Modurail/NGM-Power-Box/README.md

# NGM Power Box
- Operational and wiring schematic for the NGM layout control box (2016 version).
- The project and the associated schematics and libraries are built using [KiCad EDA](http://kicad-pcb.org//).
- The project is managed on a [Trello project board](https://trello.com/b/fsGp1QEj).
