Modurail/NGM-Power-Box/KiCad Schematics/2016 1115 Power Box Schematic.pdf

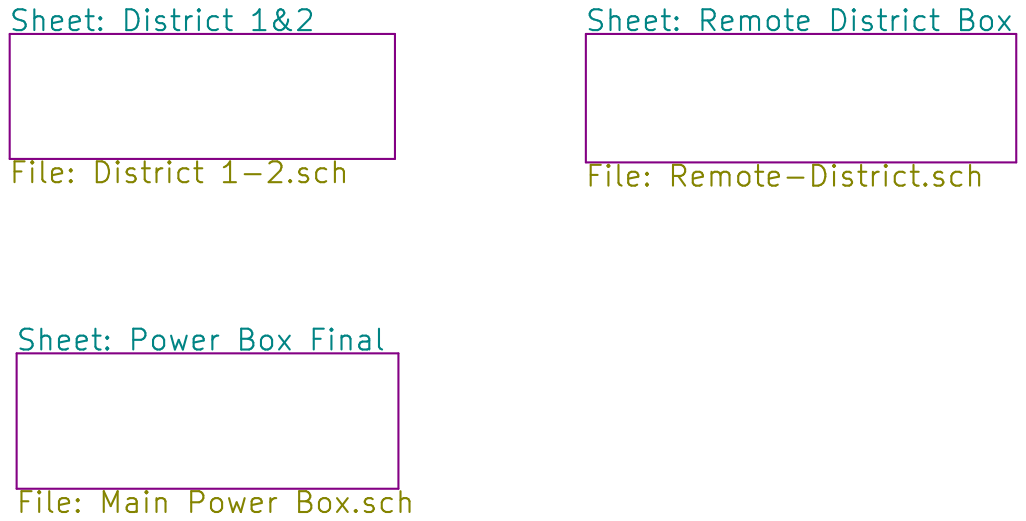
[picture p1: page 1]

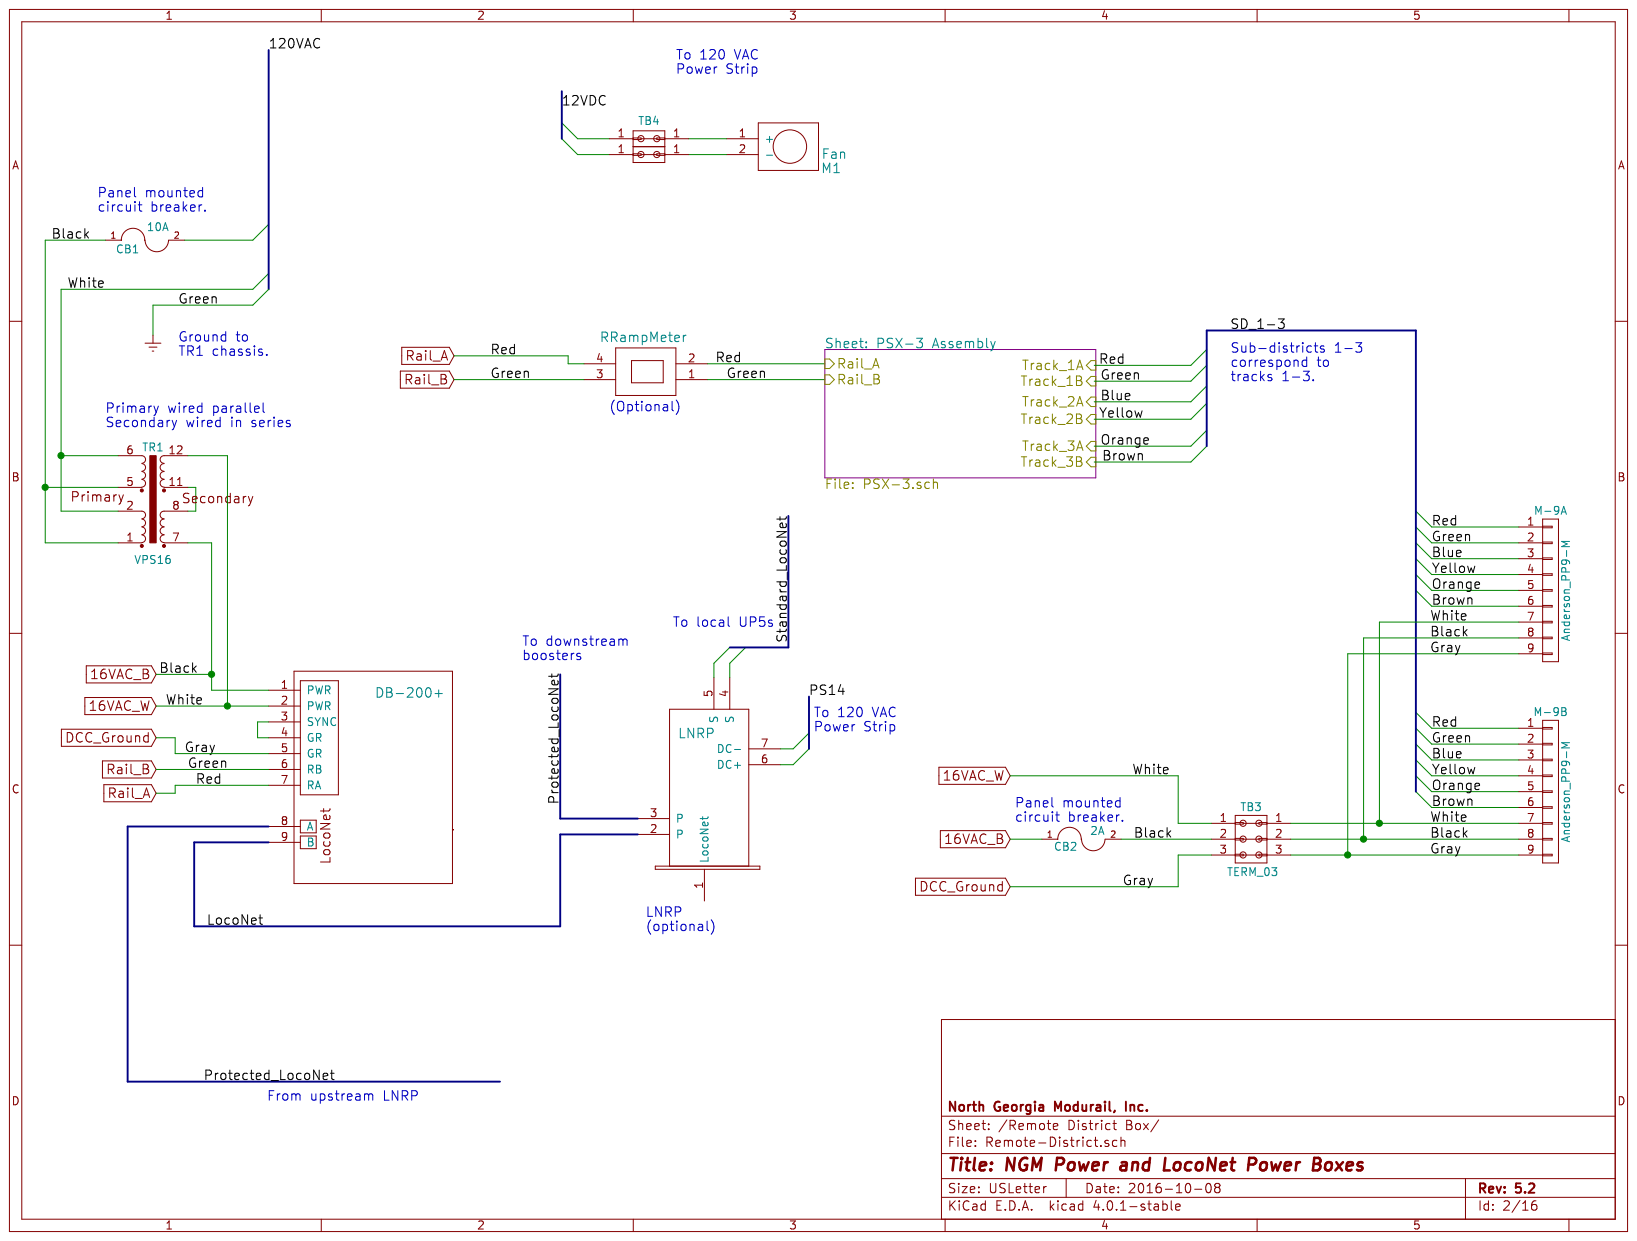
[picture p2: page 2]

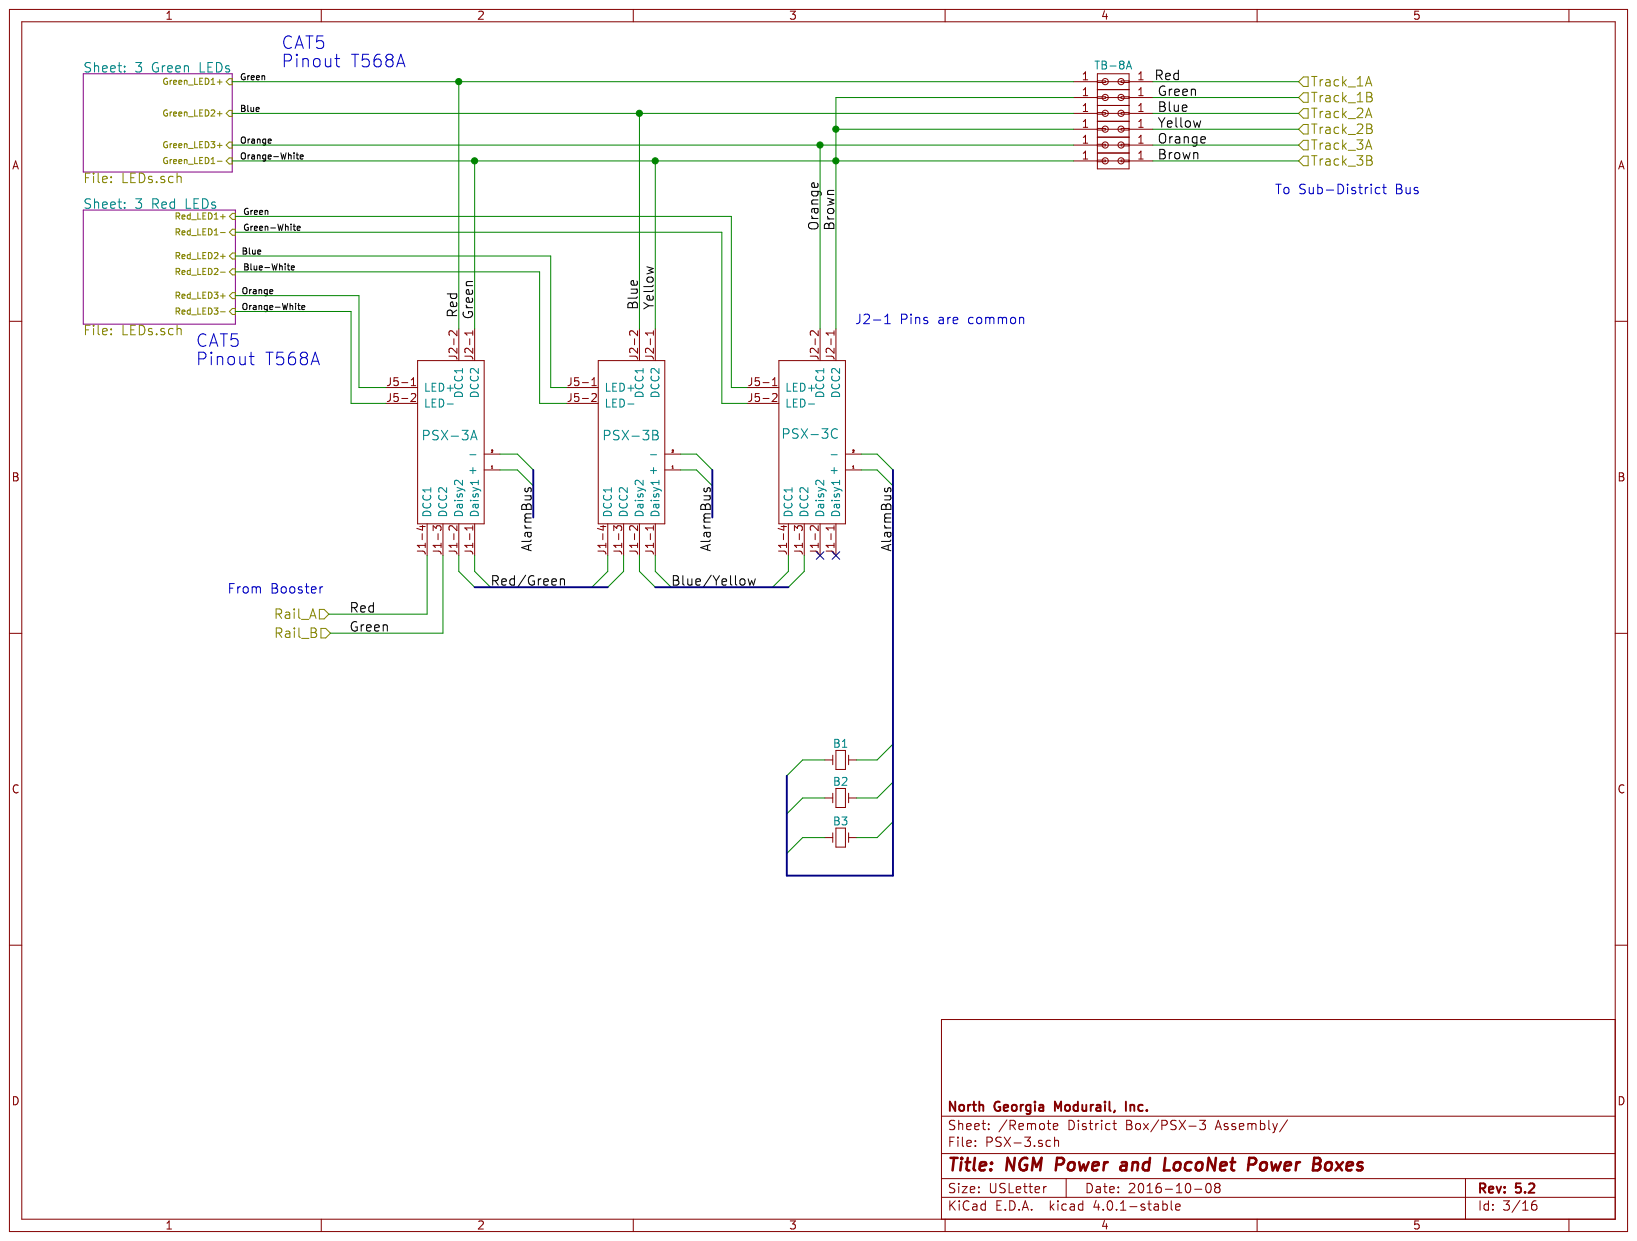
[picture p3: page 3]

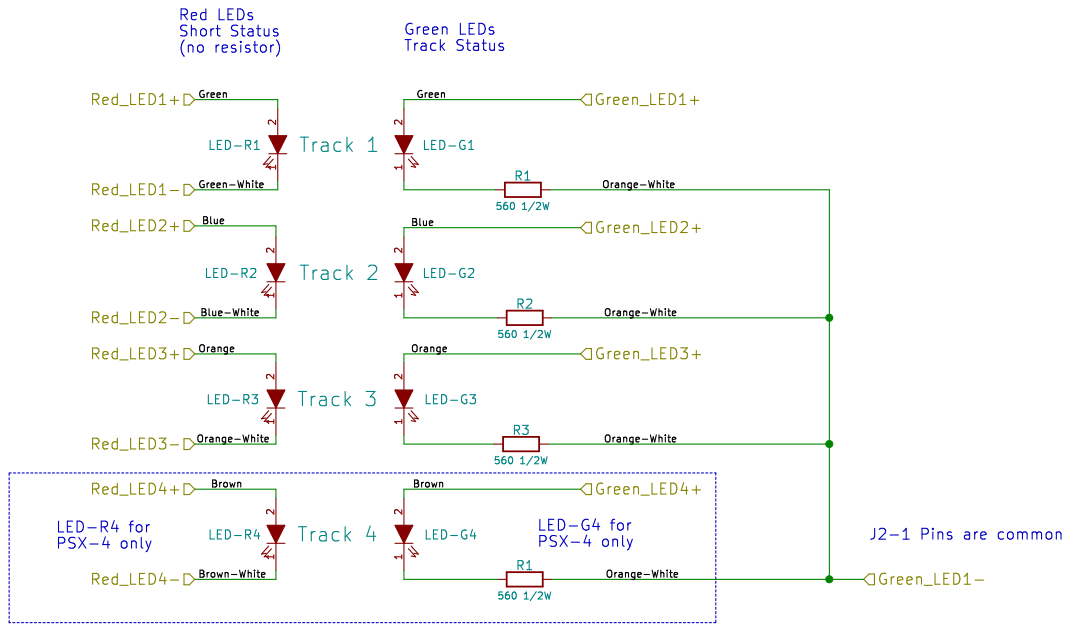
[picture p4: page 4]

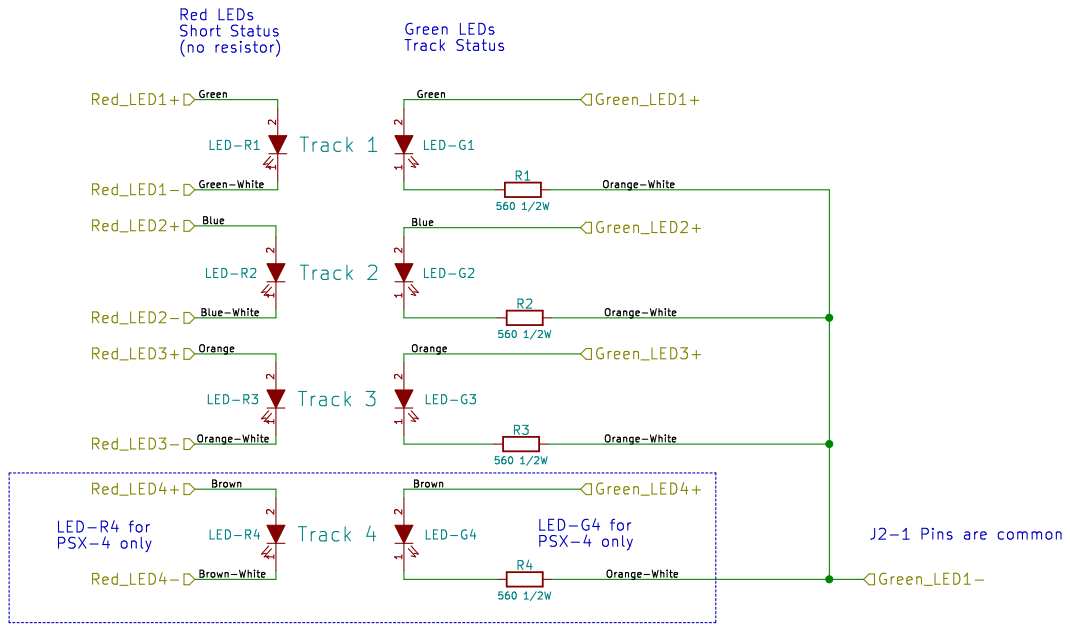
[picture p5: page 5]

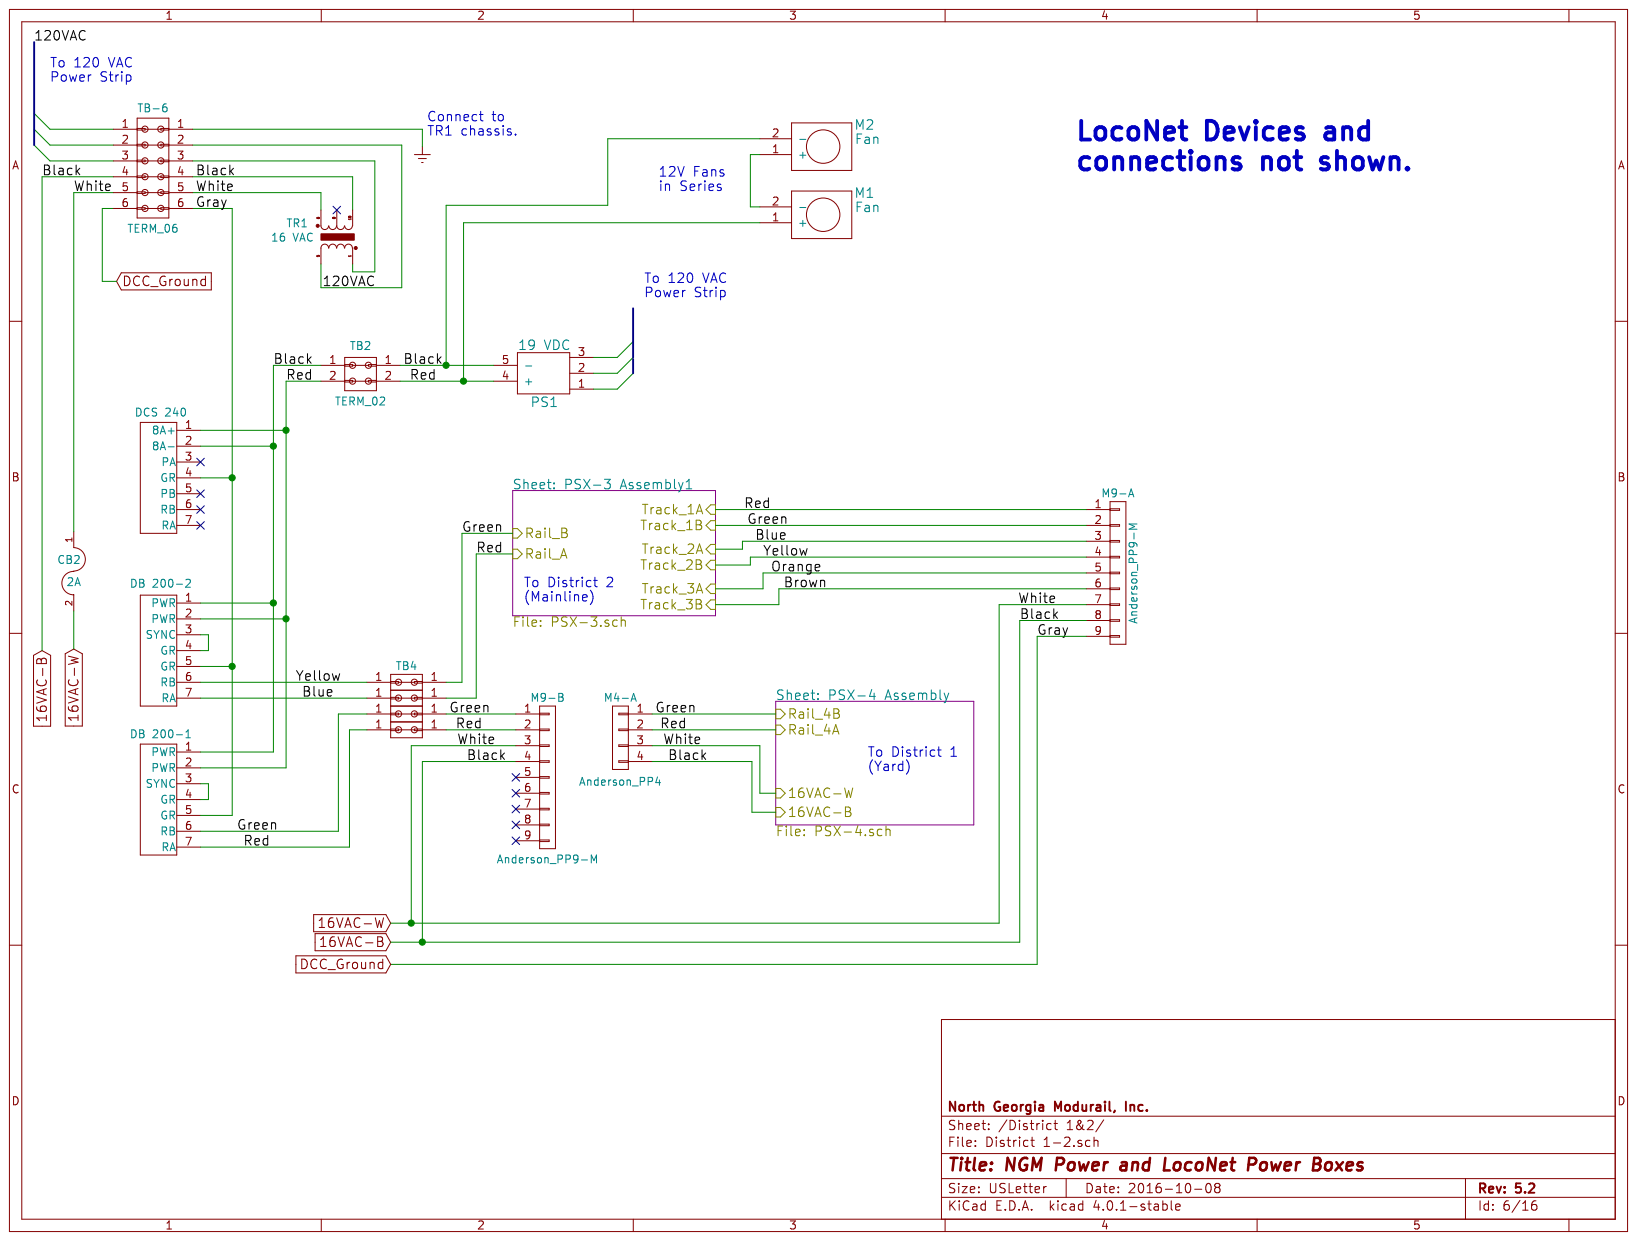
[picture p6: page 6]

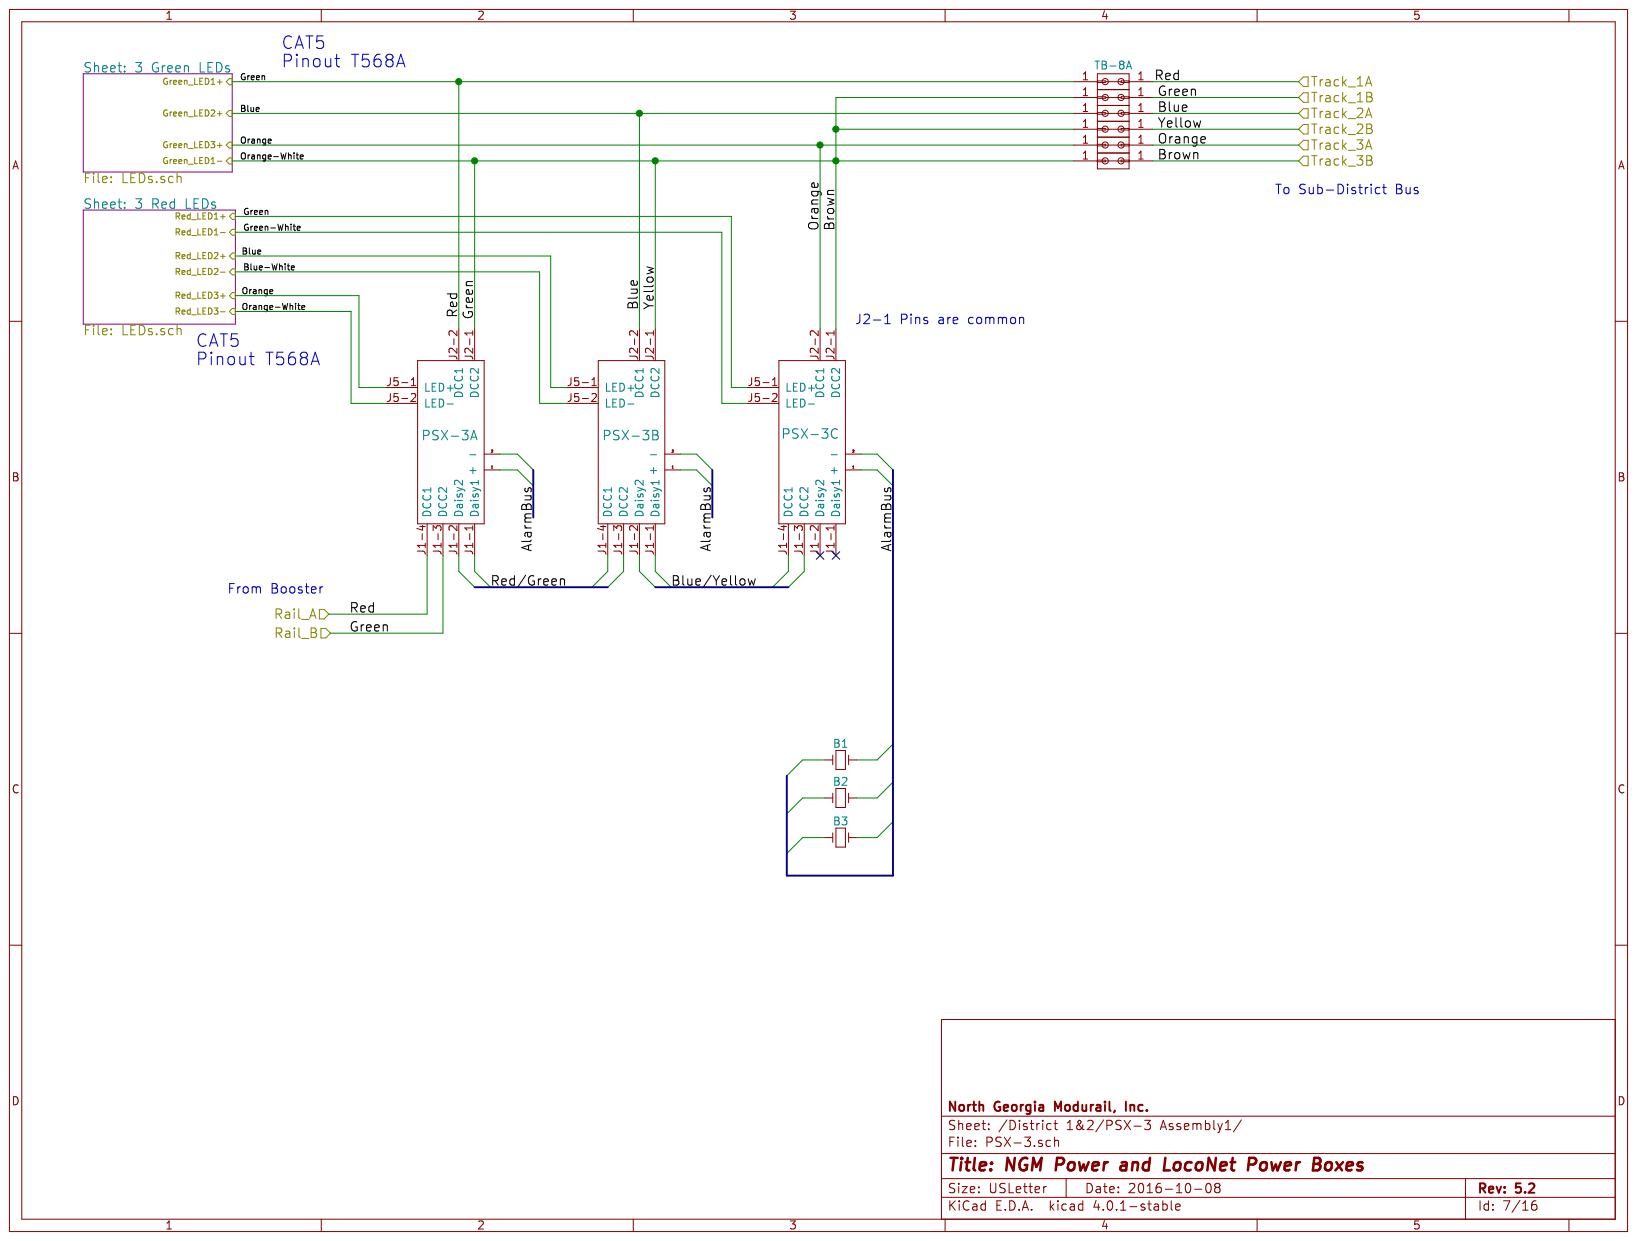
[picture p7: page 7]

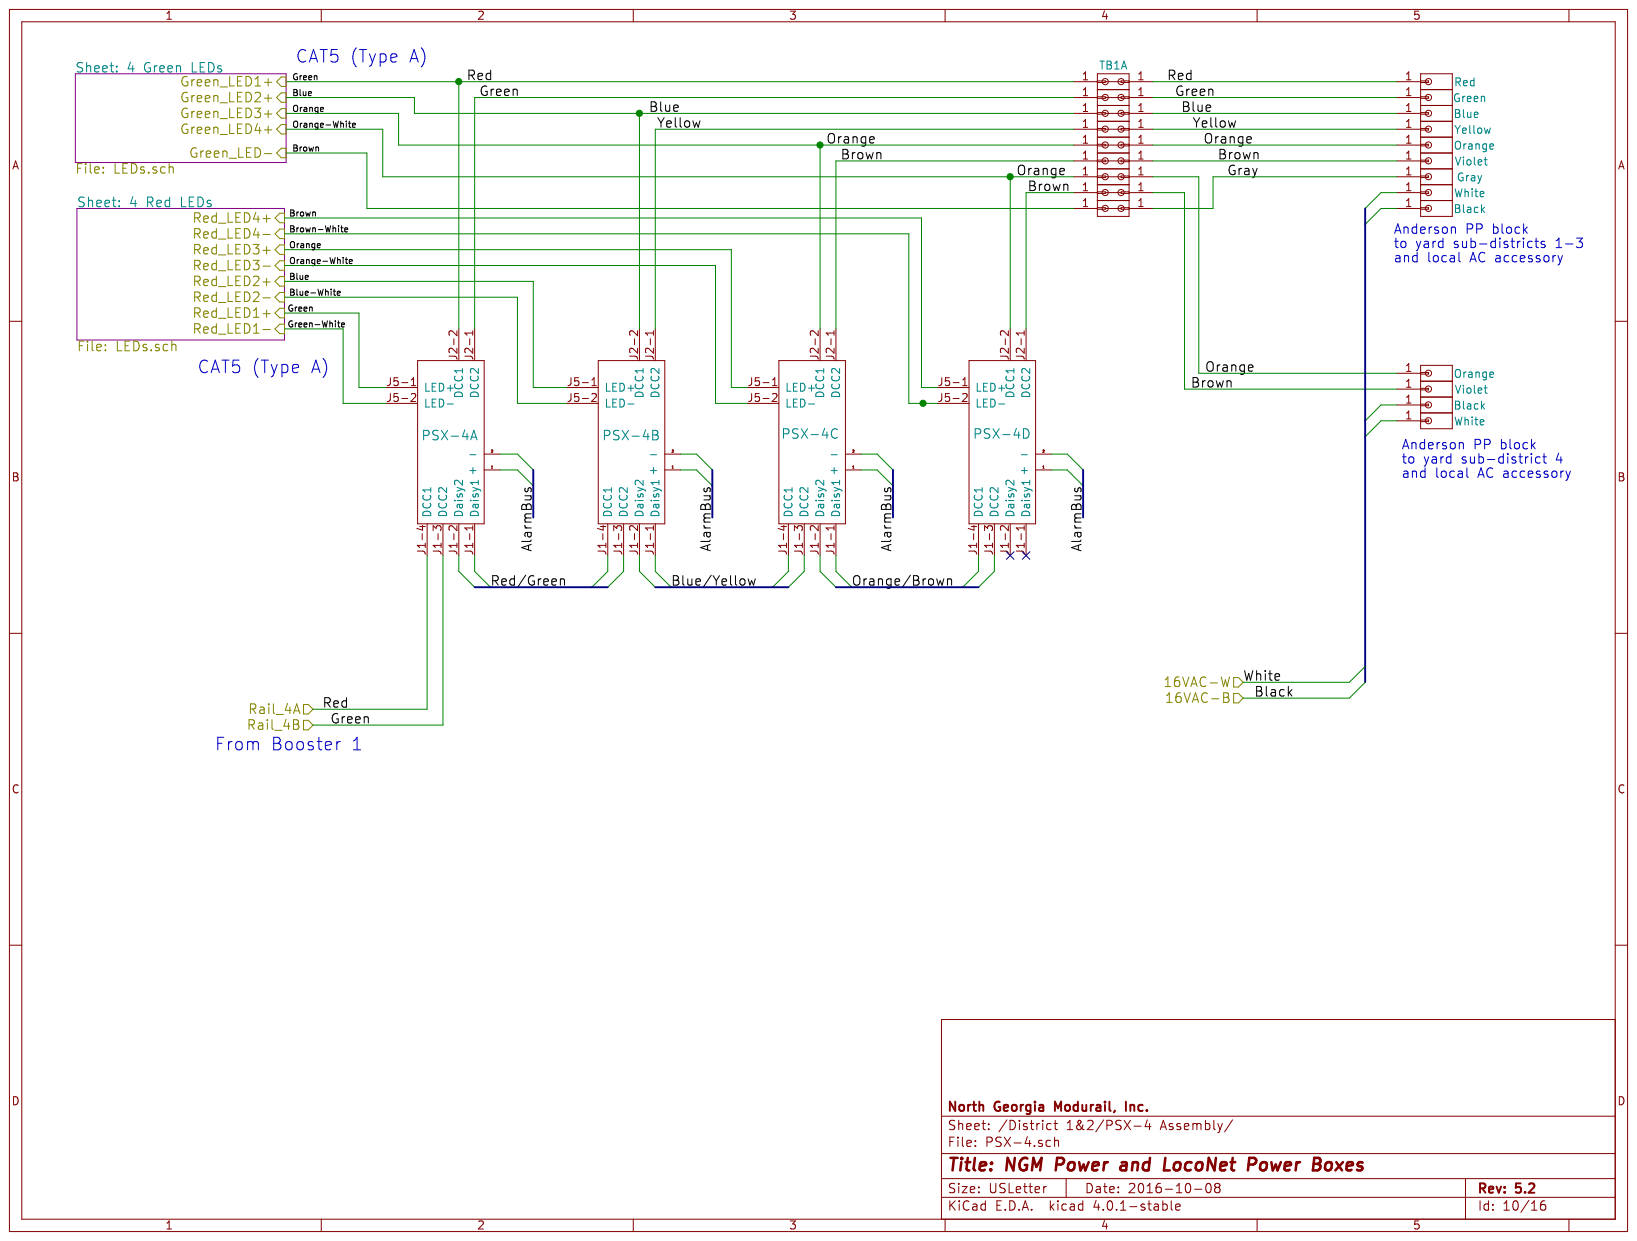
[picture p8: page 10]

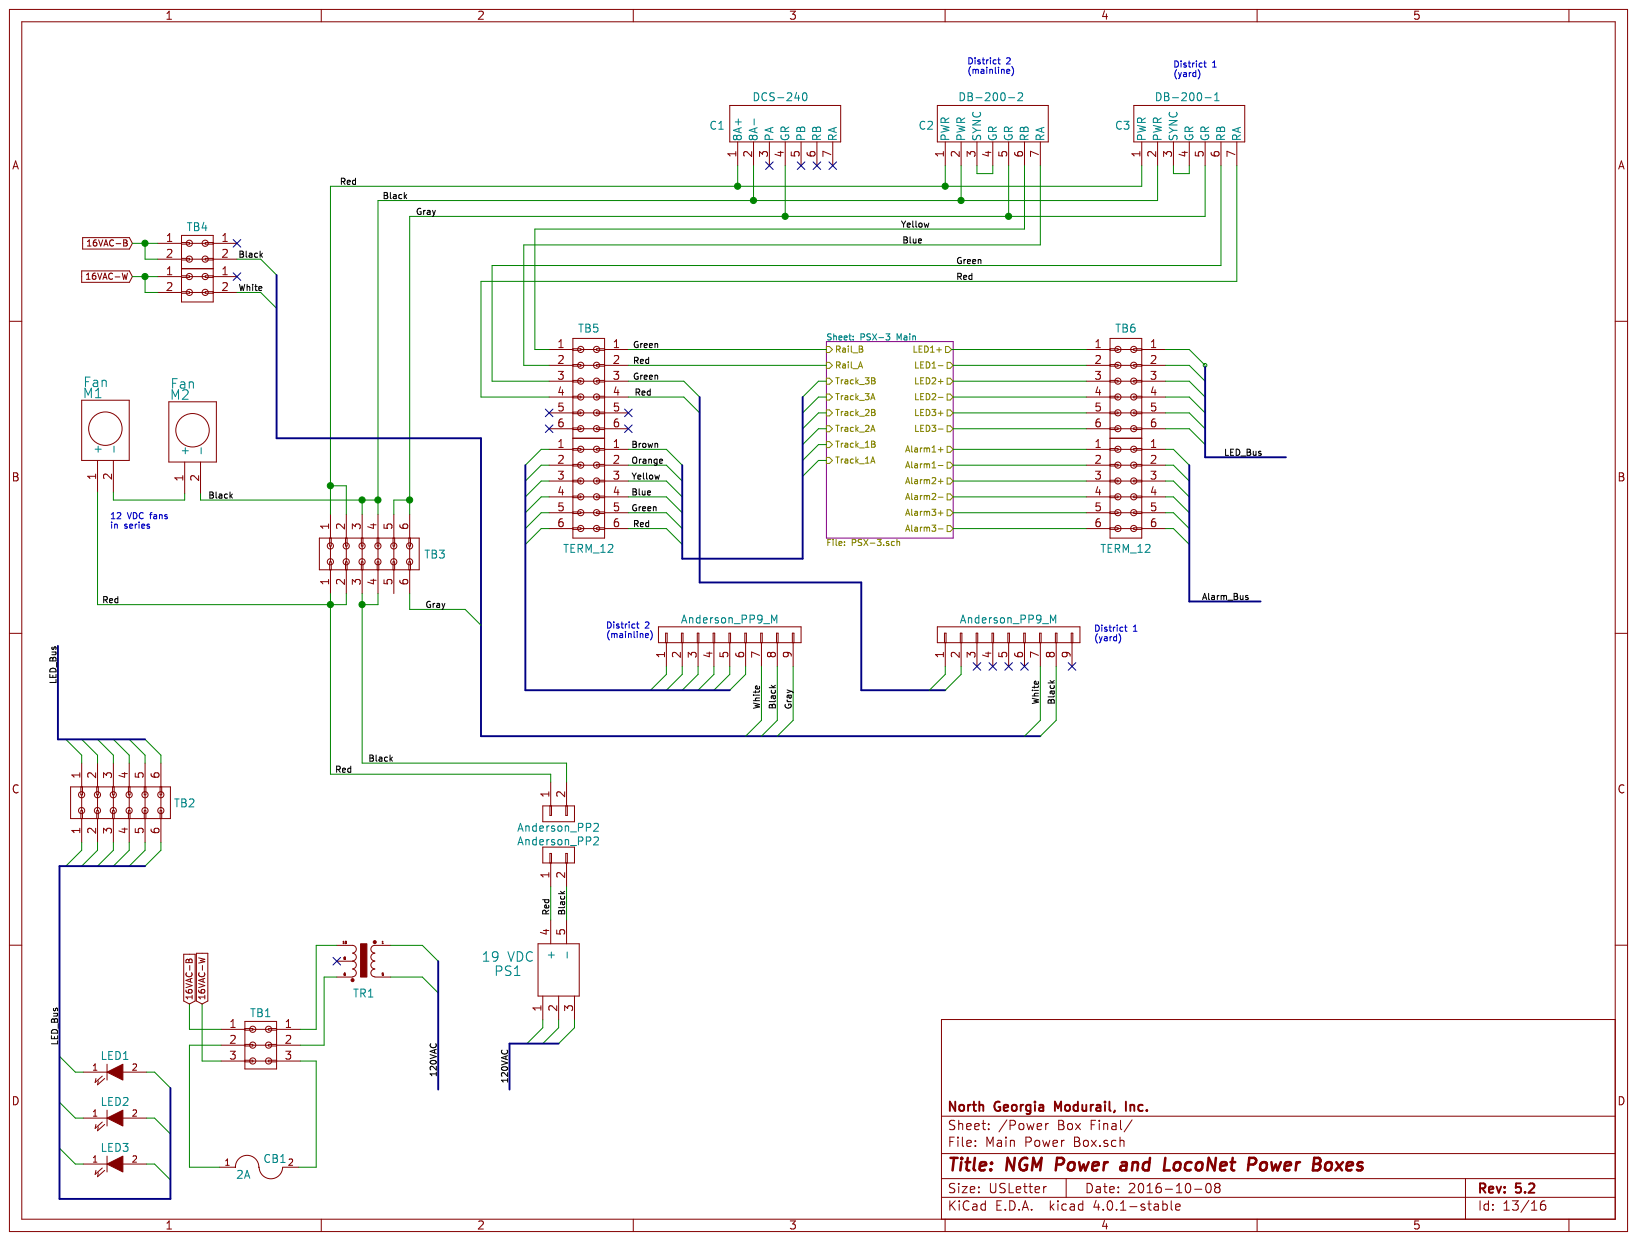
[picture p9: page 13]

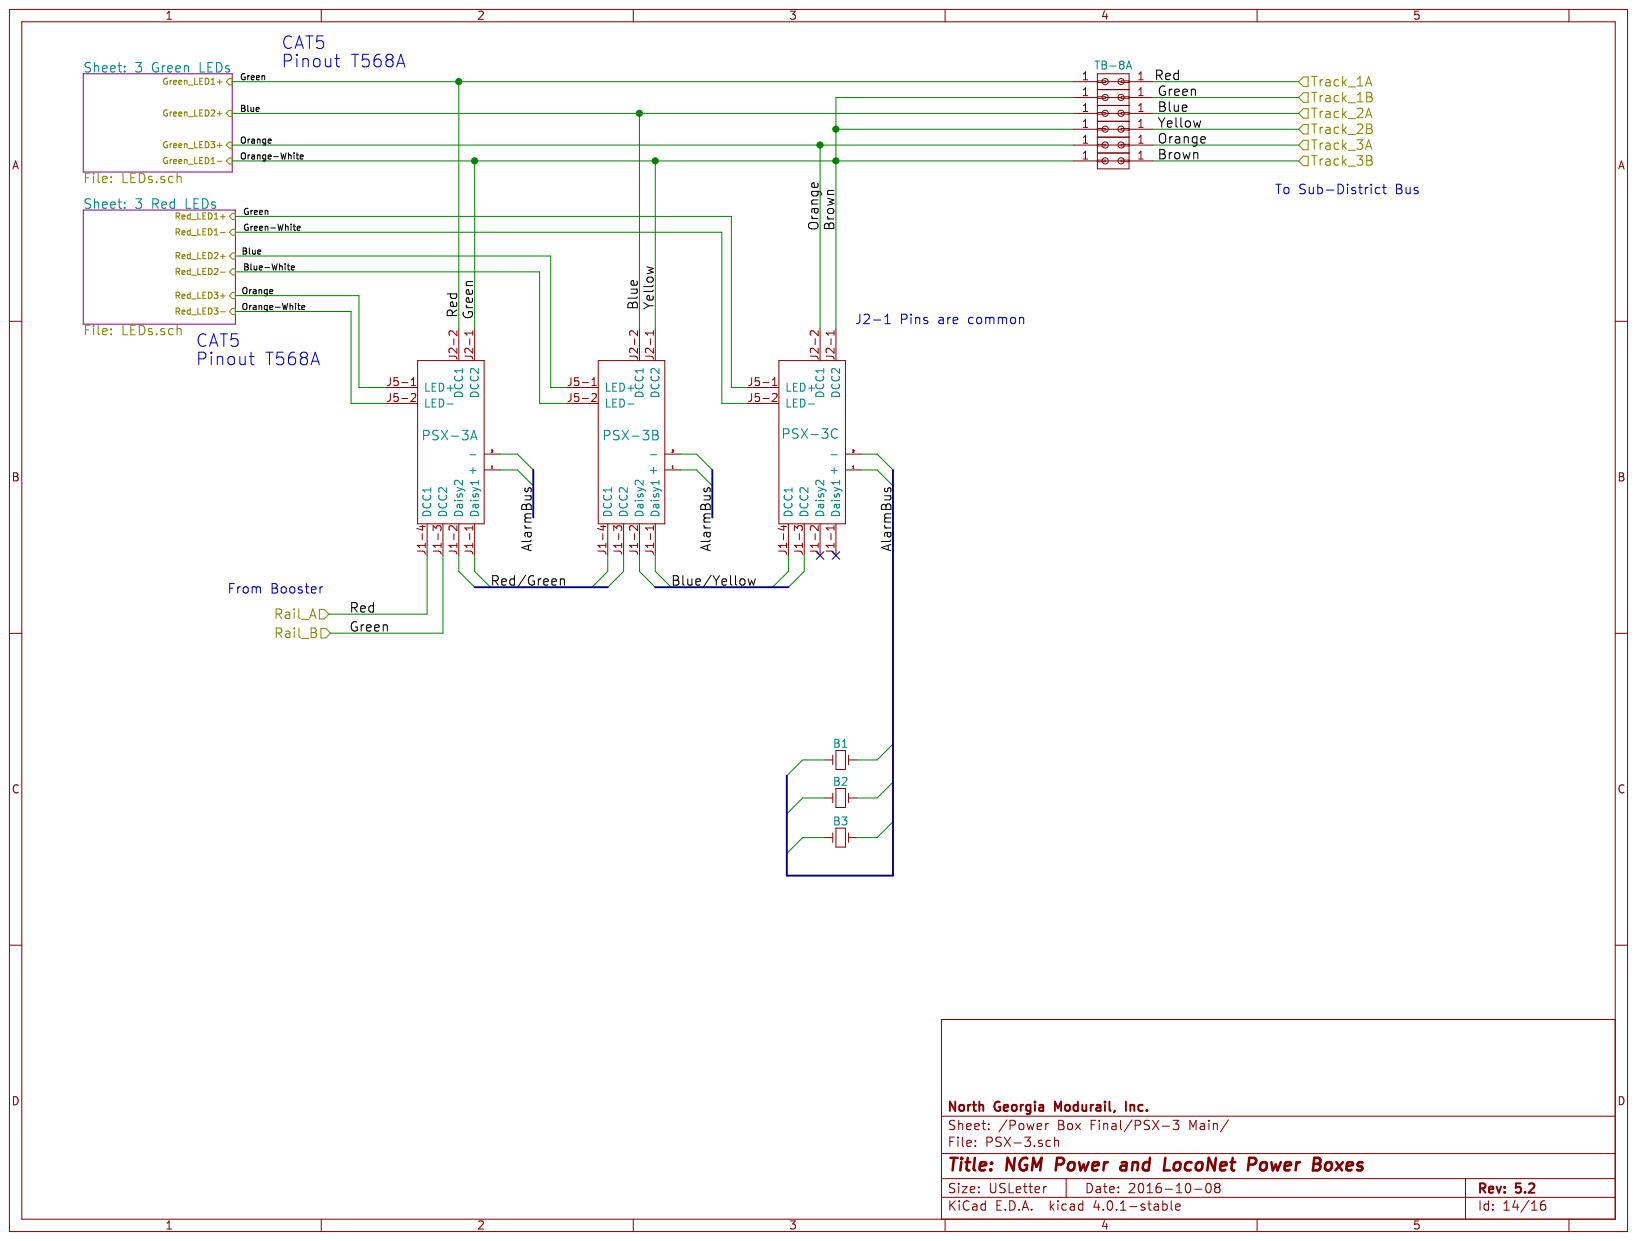
[picture p10: page 14]
