Modurail/NGM-Power-Box/KiCad Schematics/2016 1011 Power Box Schematic.pdf

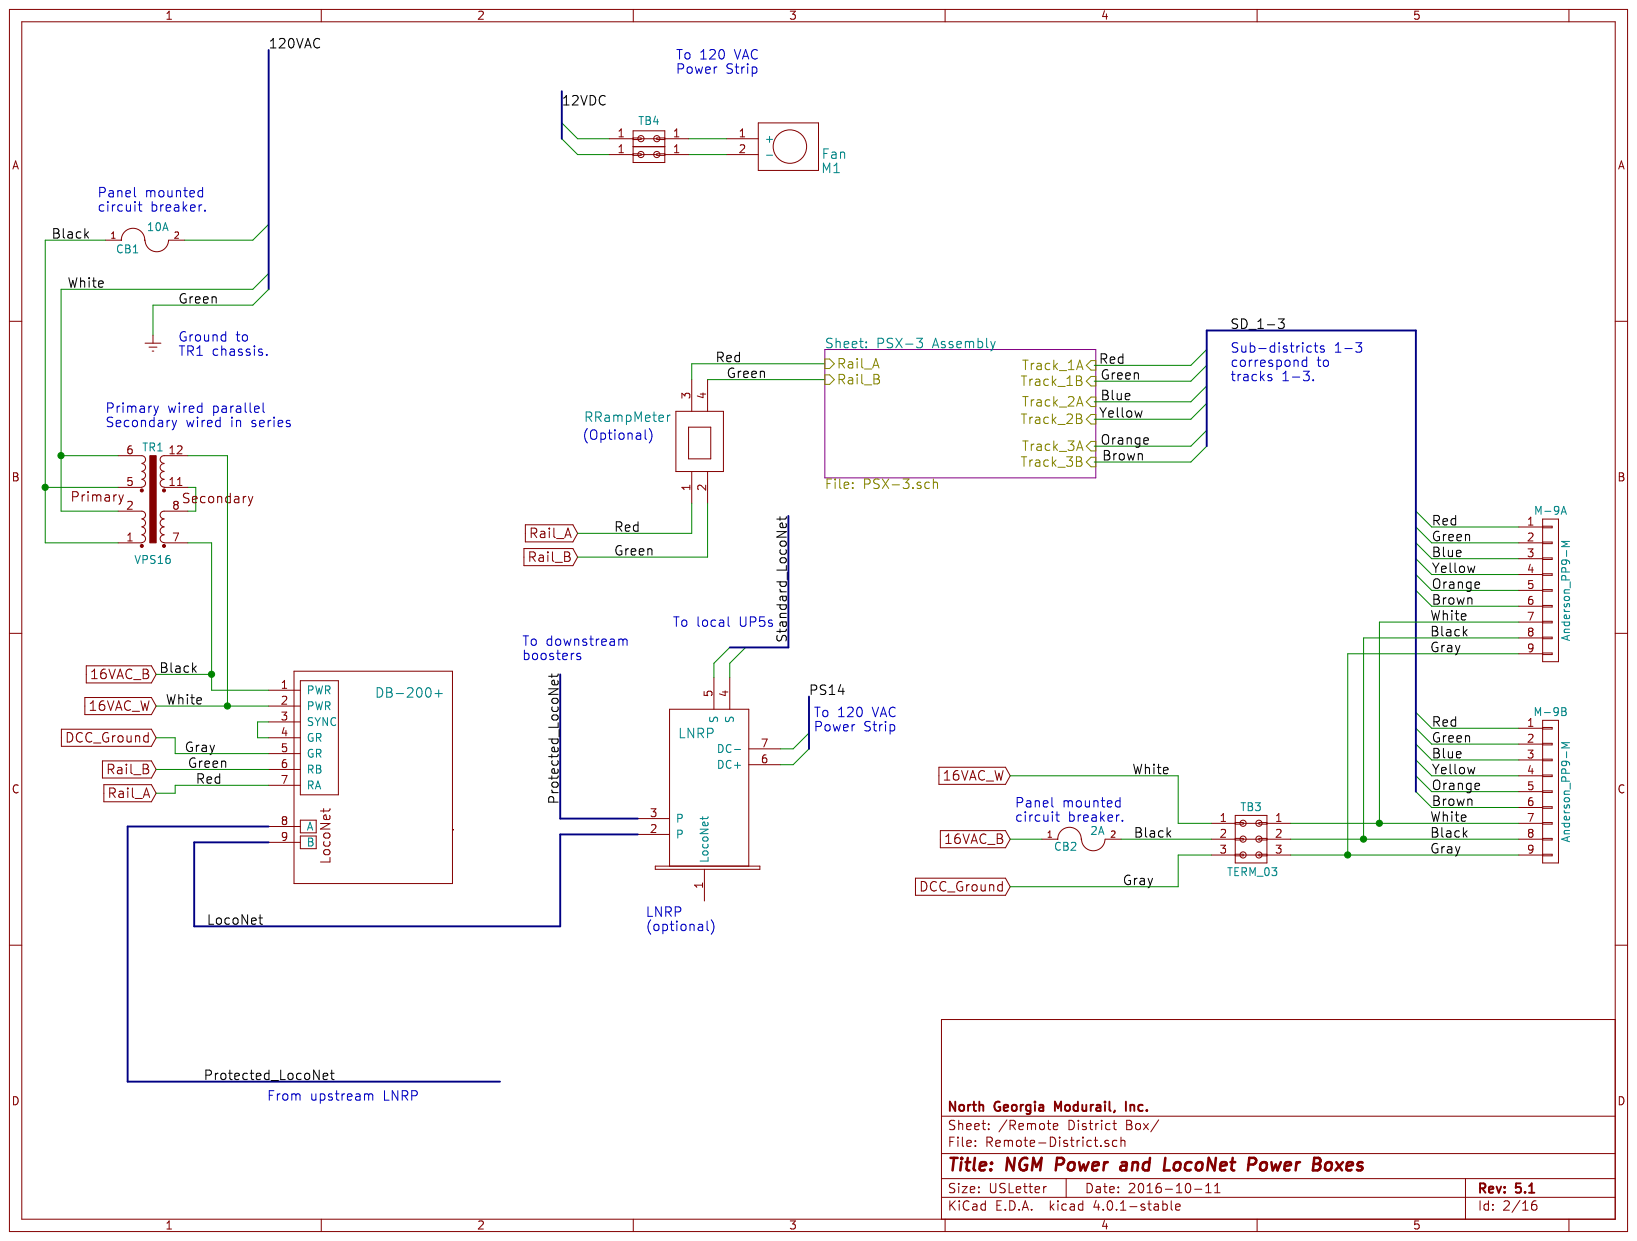
[picture p11: page 2]

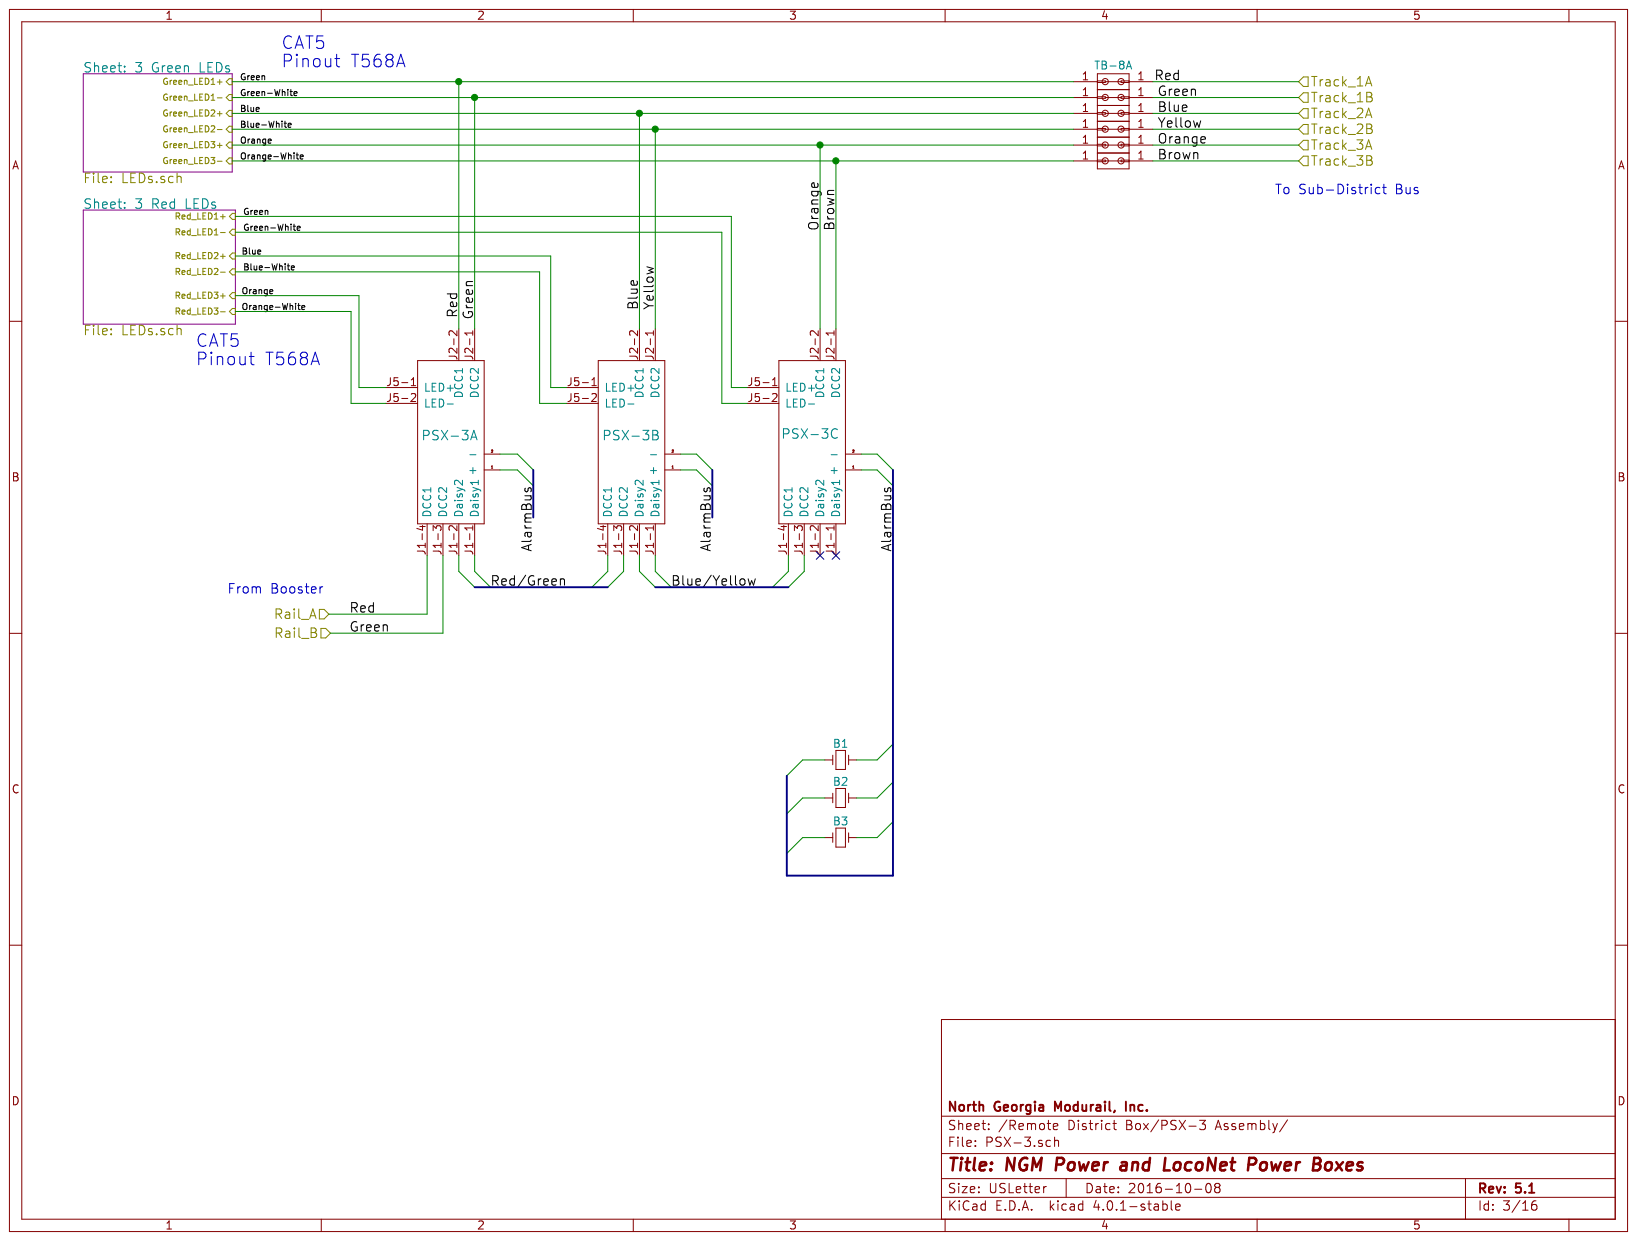
[picture p12: page 3]

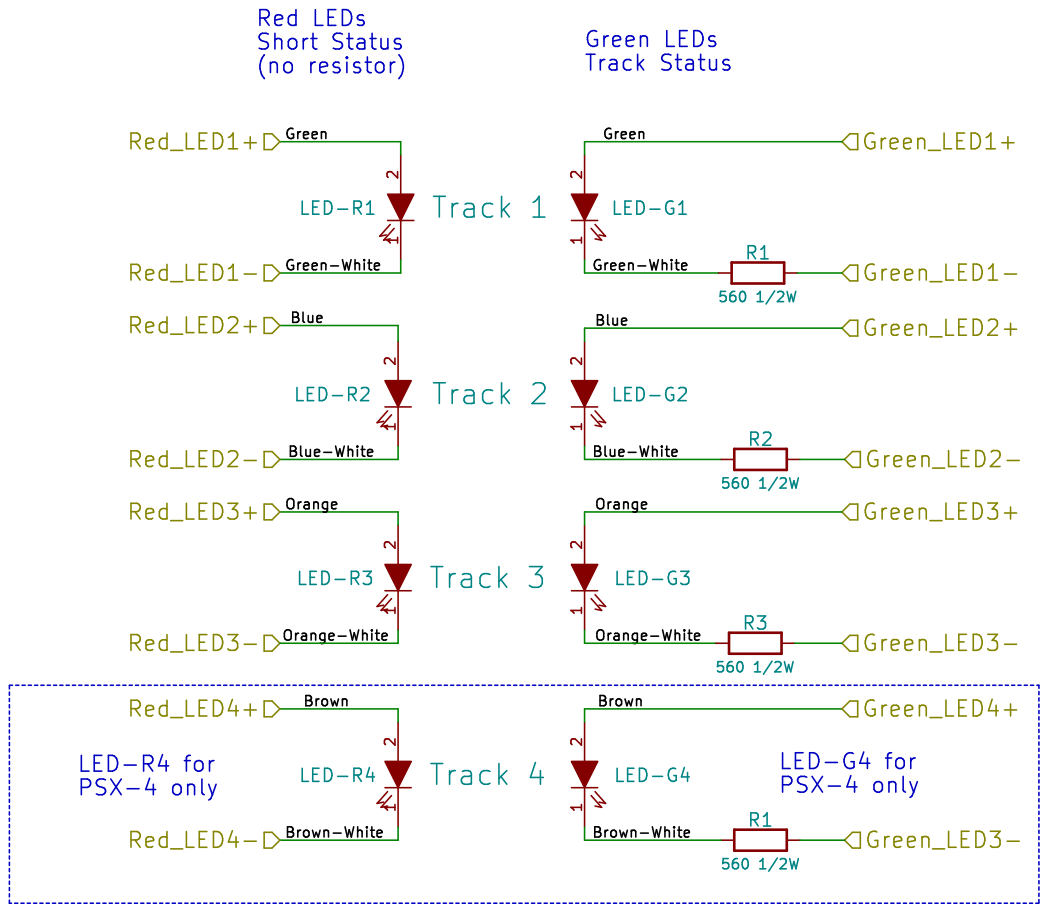
[picture p13: page 4]

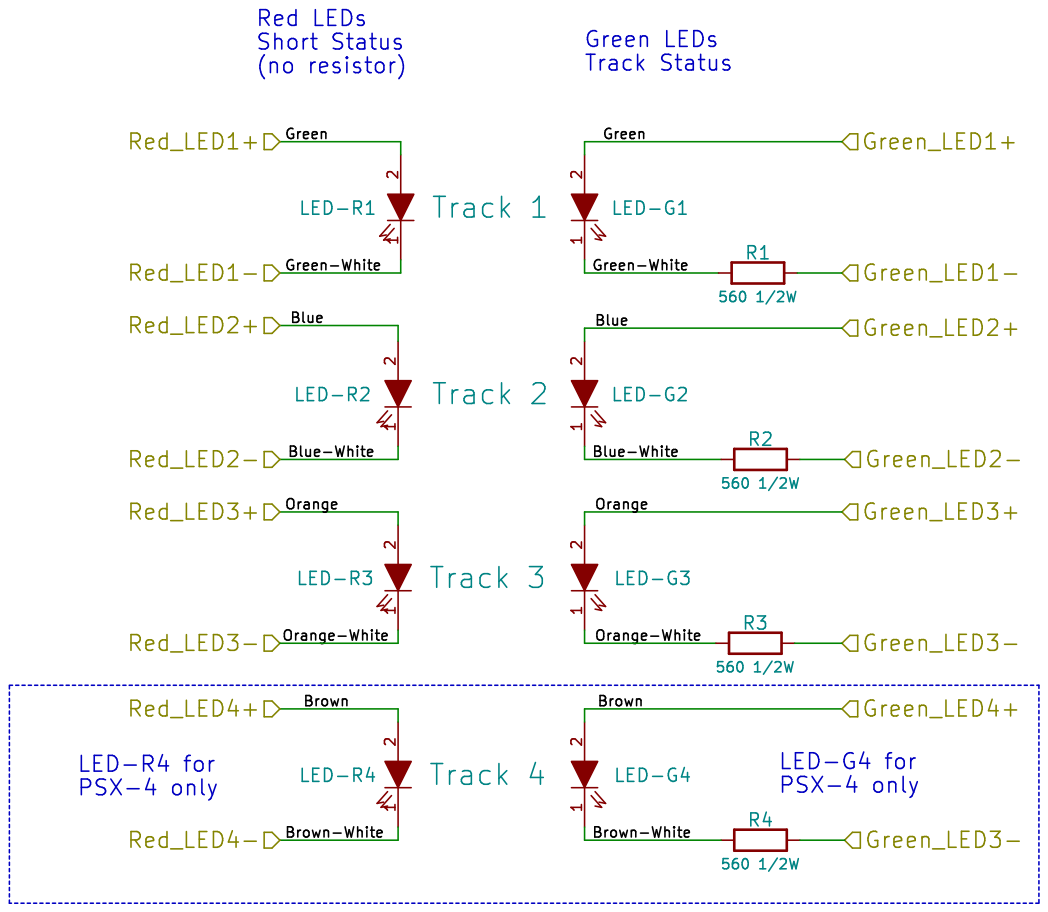
[picture p14: page 5]

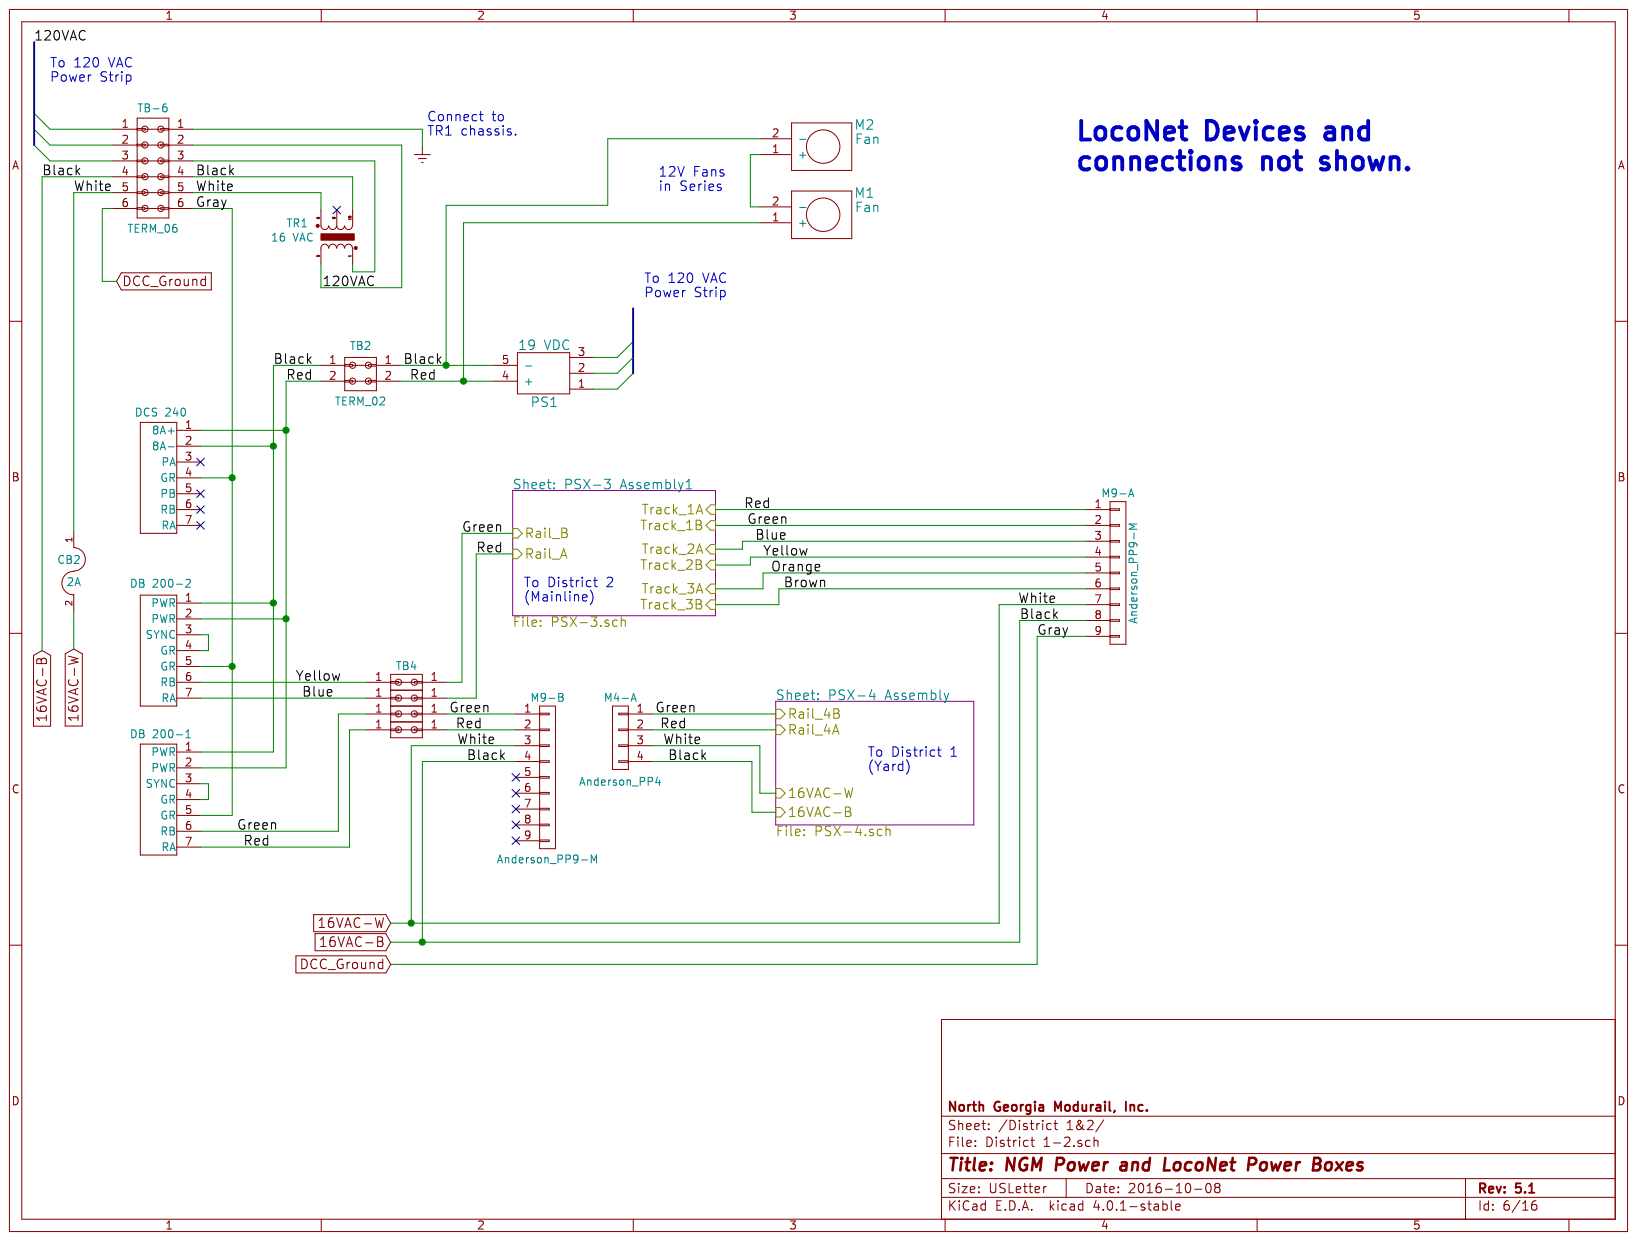
[picture p15: page 6]

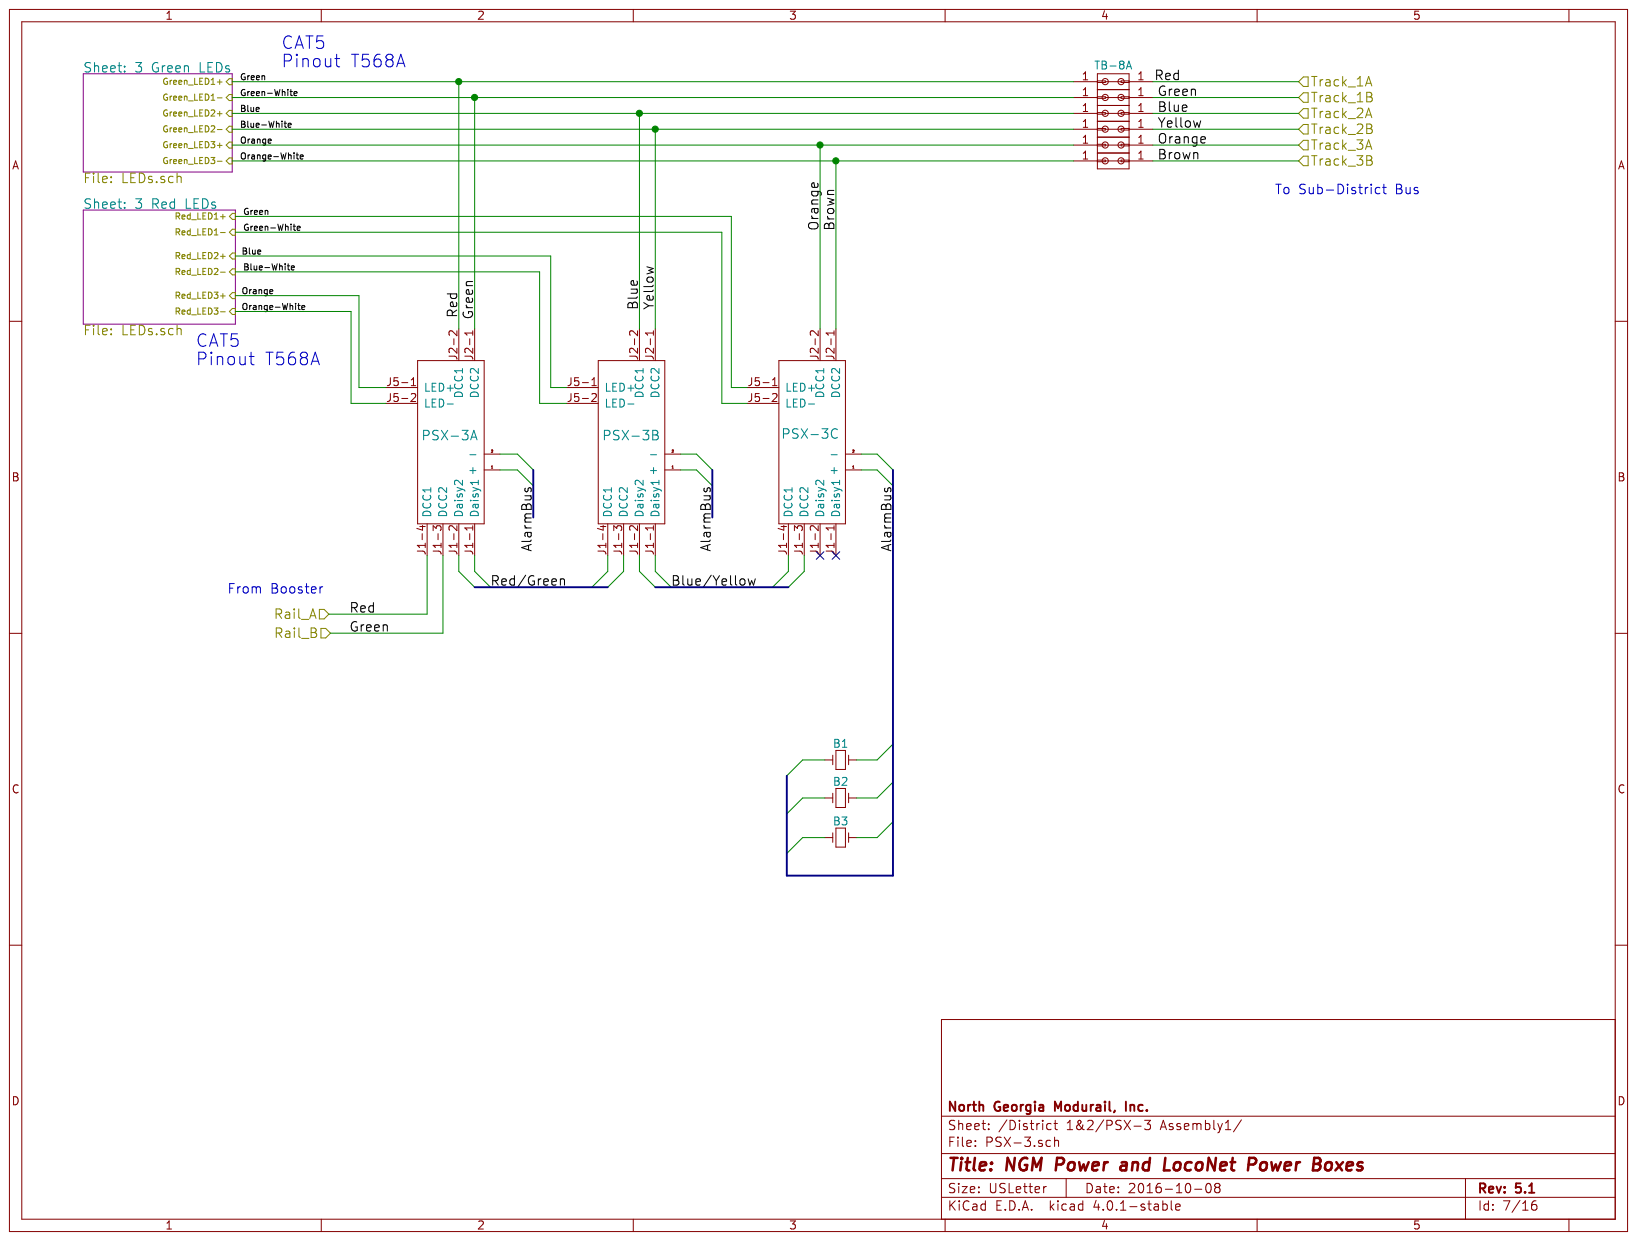
[picture p16: page 7]

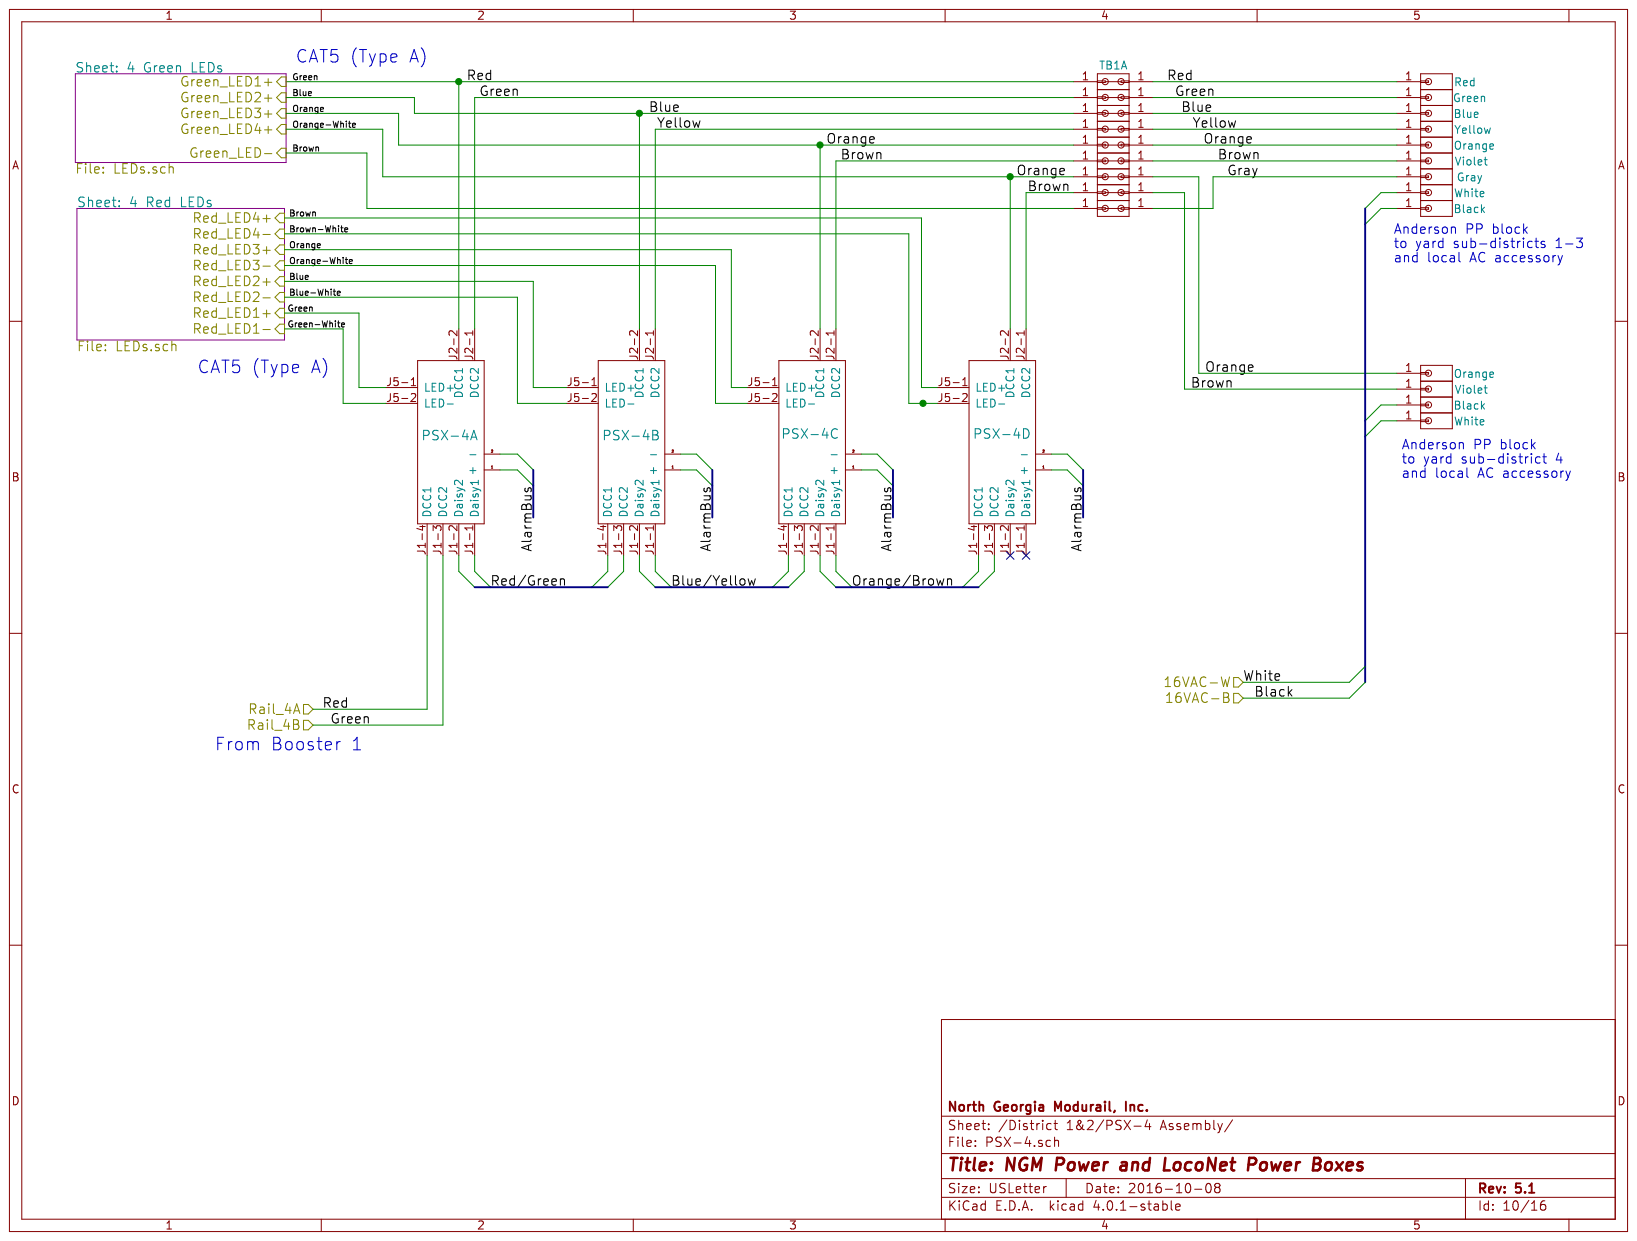
[picture p17: page 10]

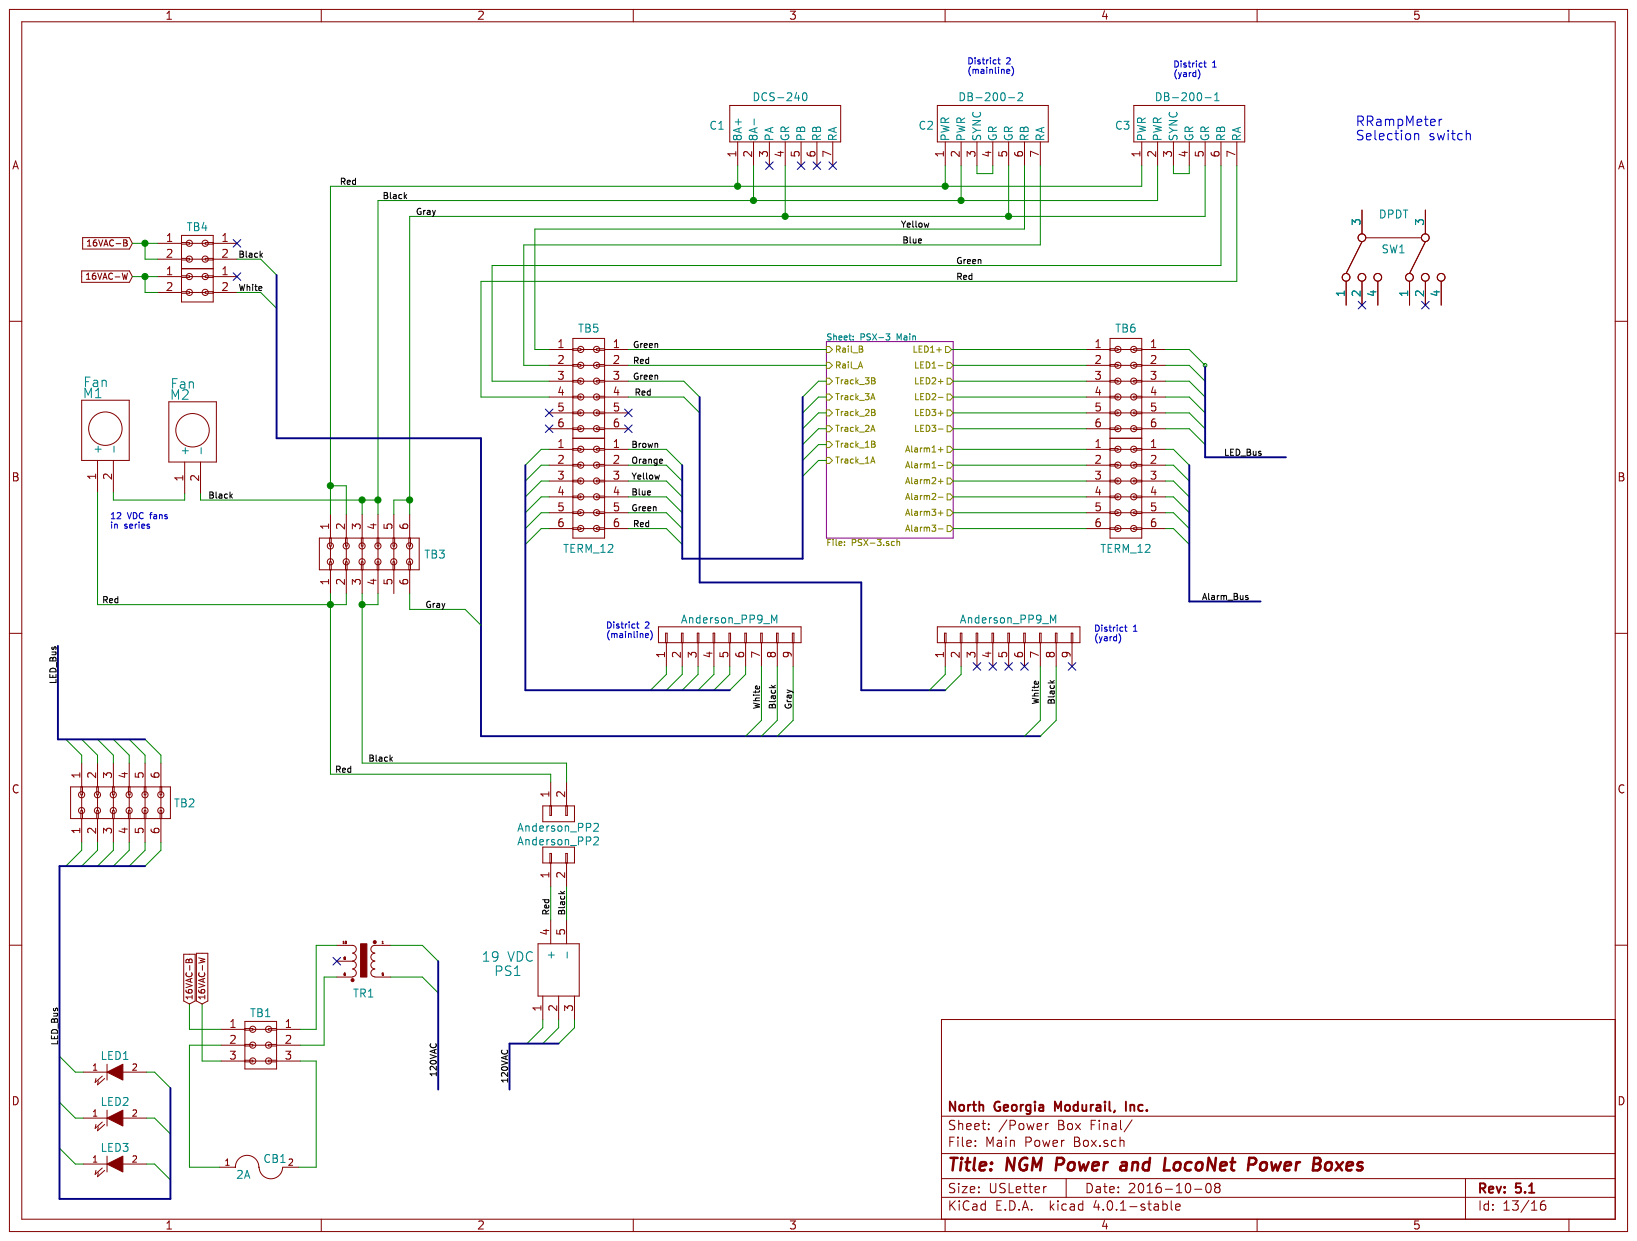
[picture p18: page 13]

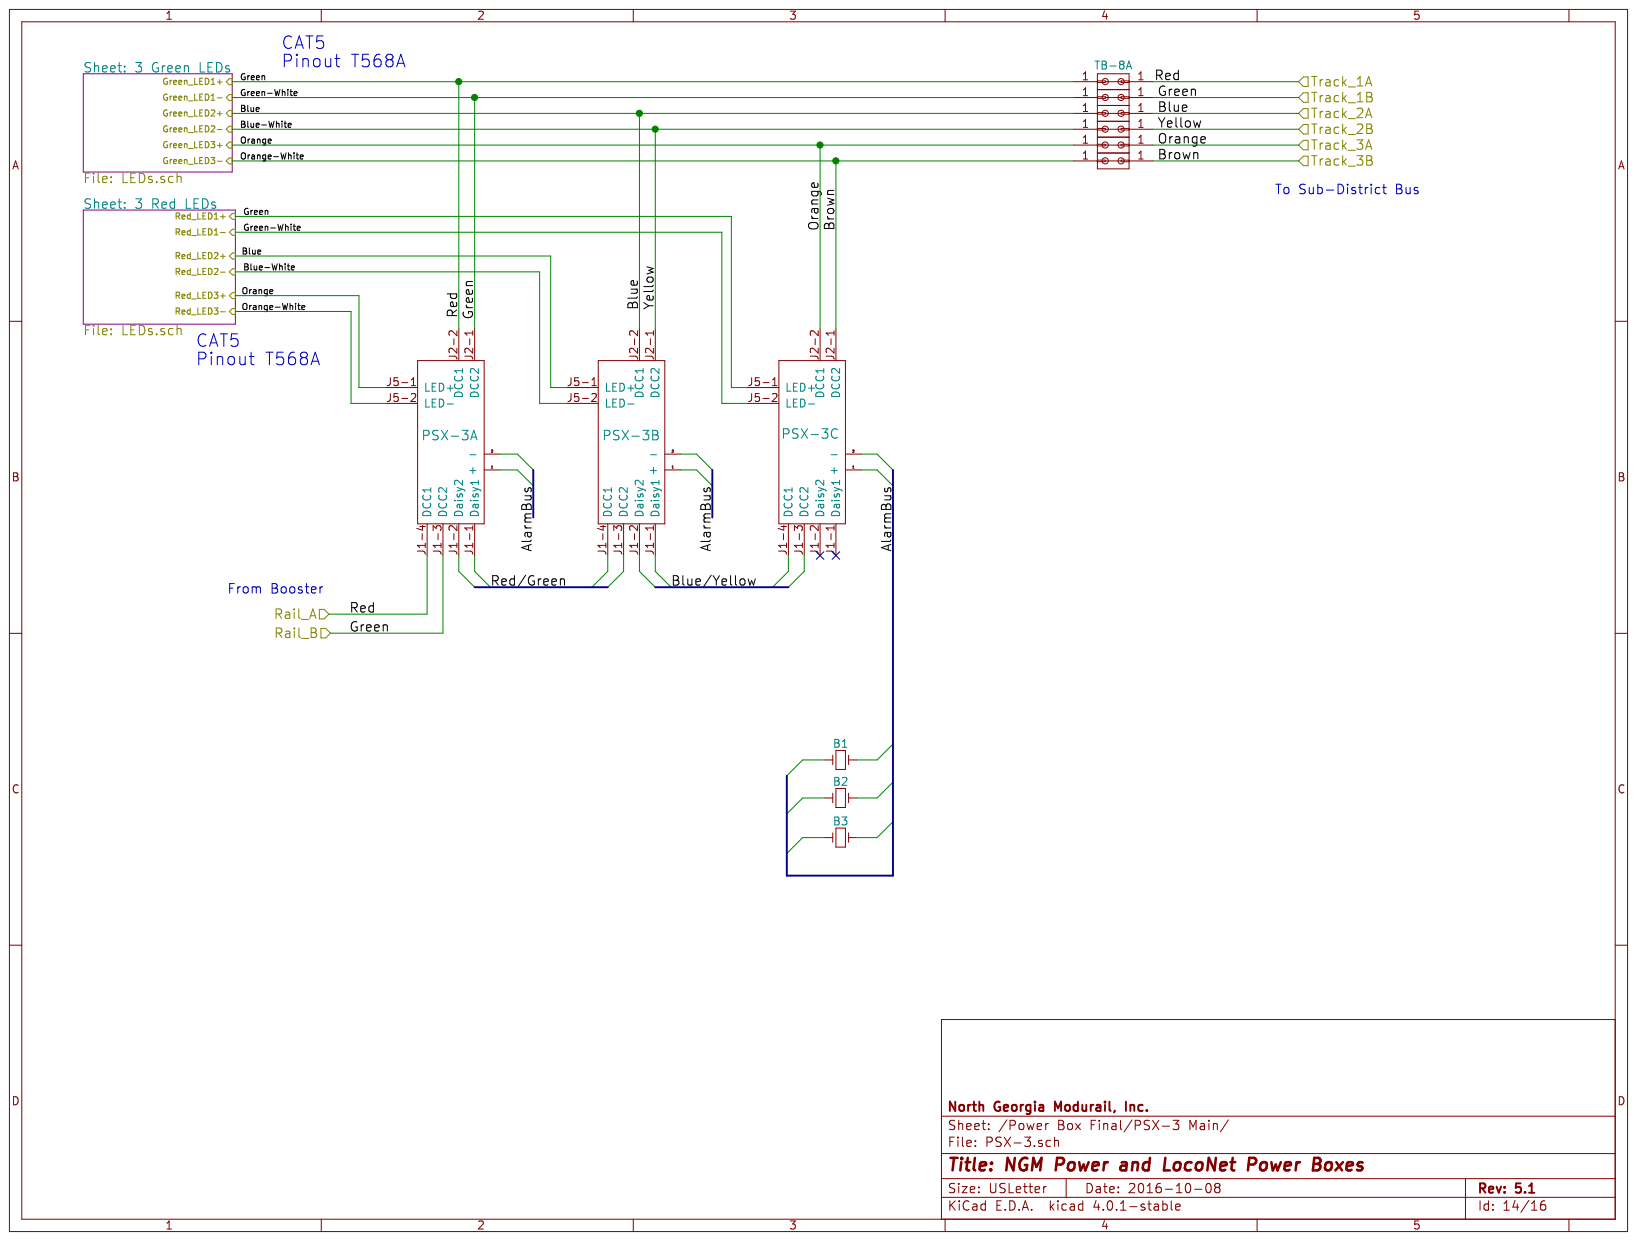
[picture p19: page 14]
