Modurail/NGM-Power-Box/(commit log)

2016-06-30 Added KiCad files
    Created a new project file which auto-created the .sch and .kicad_pcb
    files.
    [NGM Power Box.kicad_pcb, NGM Power Box.sch]
2016-08-13 Updated some KiCad schematic files and libraries
    Added some library files and updated the schematic
    [NGM Power Box.sch]
2016-08-13 Moved Power Box Specs
    Moved to subfolder
2016-08-14 Rename D:/Synced/github repos/NGM-Power-Box/StackEdit Docs to StackEdit-Docs/Power Box Specifications
    Moved to better location
2016-08-14 Delete Power Box Specs.md
    All of this content was copied into another file.
2016-08-15 Rename Power Box Specifications to Power Box Specifications.md
    made explicitly a markdown file extension
2016-08-15 Update Power Box Specifications.md
    spelling
2016-08-27 Updated schematic
    Reorganized folder and updated the schematic to include multiple sheets.
    [District1.sch, NGM Power Box.kicad_pcb, NGM Power Box.sch, Remote-District.sch]
2016-08-28 Added R to power supply
    Added a 1000 ohm bleeder resistor to the D1 power supply.
    [District1.sch]
2016-08-28 Changed LocoNet connection
    Moved connection from DB to DCS.
    [District1.sch]
2016-08-29 Updated schematic
    Added 10A circuit breaker.
    [District1.sch, Remote-District.sch]
2016-08-29 Schematic updates and printed
    More minor changes to the schematic and printed to PDF.
    [District1.sch, Remote-District.sch]
2016-09-07 Update schematic
    [Remote-District.sch]
2016-09-22 Updated schematics
    Fixed wiring using the correct pin-outs for the Triad transformers. Made
    other minor changes.
    [District 1 alt.sch, District1.sch, NGM Power Box.sch, Remote-District.sch]
2016-10-01 Updated schematic to include extra sheets.
    Added several alternate wiring sheets and made some changes to the
    schematic to reflect team decision. More to come.
    [District 1 alt.sch, District 1-2.sch, District1.sch, NGM Power Box.sch, PSX-4.sch, Remote-District.sch]
2016-10-04 Updated schematic
    [District 1 alt.sch, District 1-2.sch, District1.sch, Main Power Box.sch, NGM Power Box.sch, PSX-4.sch, Remote-District.sch]
2016-10-08 Simplified schematic
    Added heirarchy sheets to simplify the schematic.
    [District 1 alt.sch, District 1-2.sch, District1.sch, LEDs.sch, Main Power Box.sch, NGM Power Box.sch, PSX-3.sch, PSX-4.sch]
2016-10-08 Fixed LED wire assignments
    All of the PSX-3s were wired differently from the PSX-4. This change
    reflects the actual wiring, not the original intended wiring.
    [LEDs.sch, PSX-3.sch]
2016-10-09 Minor schematic changes
    [District 1-2.sch, Main Power Box.sch]
2016-10-09 Updated schematic (reverted)
    Reverted back to the correct wiring as the boards were rewired to spec.
    [District 1-2.sch, LEDs.sch, PSX-3.sch]
2016-10-11 Corrected transformer wire colors
    Corrected error in Triad transformer colors to match black to 'hot' and
    white to 'neutral'.
    [Remote-District.sch]
2016-10-11 Updated schematic for remote boxes
    Cleaned up the wiring, removed an unnecessary terminal block and
    clarified transformer wiring.
    [District 1-2.sch, LEDs.sch, Main Power Box.sch, NGM Power Box.sch, PSX-3.sch, PSX-4.sch, Remote-District.sch]
2016-10-11 Updated schematic
    Also deleted old PDFs.
    [District 1-2.sch]
2016-10-20 Updated schematic
    Minor cleanup and update of PDF
    [Main Power Box.sch, Remote-District.sch]
2016-11-10 Simplified schematic
    Minor change to remote box wiring to simplify visual.
    [Remote-District.sch]
2016-11-15 Updated schematic to v5.2
    Changed the green LED wiring to reflect common rail on pin J1-2 on PSX
    units.
    [District 1-2.sch, LEDs.sch, Main Power Box.sch, NGM Power Box.sch, PSX-3.sch, PSX-4.sch, Remote-District.sch]
